paulmit000/ATLAS_6DOF_robotic_arm/ez roboarm editable.step

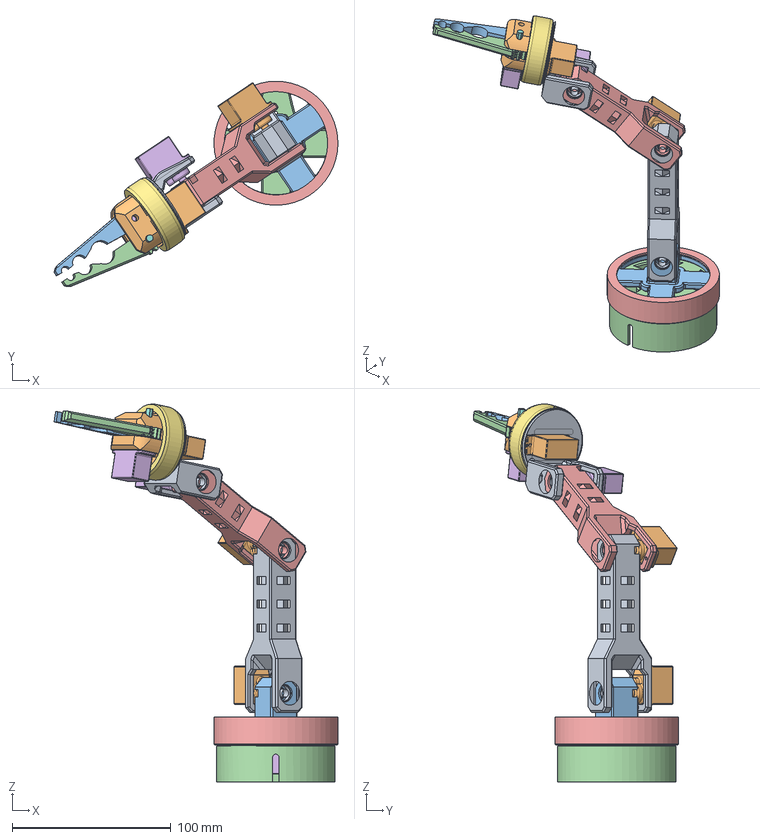
[picture p1: CAD file, 2026-10-25]
ez roboarm editable.step
178.6 x 129.3 x 237.8 mm
