paulmit000/ATLAS_6DOF_robotic_arm/(list of files, cad)

Other CAD files:
freecad_roboarm_editable.FCStd
ez roboarm editable.f3d
