paulmit000/ATLAS_6DOF_robotic_arm/(commit log)

2026-10-04 Create README for ATLAS Robot Arm project
    Add initial README with project details, features, and setup instructions.
2026-10-05 Calibrated base, shoulder, and elbow servos and fixed values in configuration layer. Swapped x and y axis on J1. Repositioned OLED display on the breadboard. Tested output voltage from ESP32 and serv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
    [main.cpp]
2026-10-05 updated calibration for elbow and tested wrist pitch joint
2026-10-09 calibrated elbow, wrist pitch, writst roll, gripper, and set new safety and rest values
2026-10-09 updated calibration values, swapped y and x axis on 2nd joystick
    [main.cpp]
